SySch415/stm32-crawler/docs/images/2026-11-01_02-40-12.png

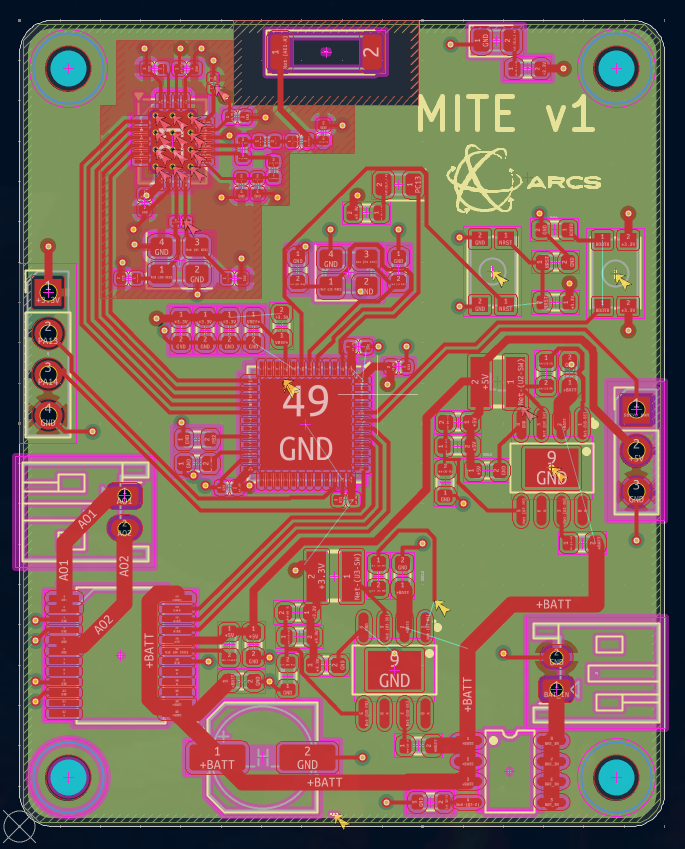
docs/images/2026-11-01_02-40-12.png
