SySch415/stm32-crawler/controller/startup.cpp

extern "C" {

#include <stdint.h>

extern uint32_t _estack;
extern uint32_t _sidata;
extern uint32_t _sdata;
extern uint32_t _edata;
extern uint32_t _sbss;
extern uint32_t _ebss;

extern int main(void);
void Reset_Handler();

void Default_Handler(void) {
  while (1)
    ;
}

void NMI_Handler(void) __attribute__((weak, alias("Default_Handler")));
void HardFault_Handler(void) __attribute__((weak, alias("Default_Handler")));
void MemManage_Handler(void) __attribute__((weak, alias("Default_Handler")));
void BusFault_Handler(void) __attribute__((weak, alias("Default_Handler")));
void UsageFault_Handler(void) __attribute__((weak, alias("Default_Handler")));
void SVC_Handler(void) __attribute__((weak, alias("Default_Handler")));
void DebugMon_Handler(void) __attribute__((weak, alias("Default_Handler")));
void PendSV_Handler(void) __attribute__((weak, alias("Default_Handler")));
void SysTick_Handler(void) __attribute__((weak, alias("Default_Handler")));
void TIM2_IRQHandler(void) __attribute__((weak, alias("Default_Handler")));

__attribute__((section(".isr_vector"))) uint32_t *vector_table[] = {
    (uint32_t *)&_estack,
    (uint32_t *)Reset_Handler,
    (uint32_t *)NMI_Handler,
    (uint32_t *)HardFault_Handler,
    (uint32_t *)MemManage_Handler,
    (uint32_t *)BusFault_Handler,
    (uint32_t *)UsageFault_Handler,
    0,
    0,
    0,
    0,
    (uint32_t *)SVC_Handler,
    (uint32_t *)DebugMon_Handler,
    0,
    (uint32_t *)PendSV_Handler,
    (uint32_t *)SysTick_Handler,

    //[44] = (uint32_t *)TIM2_IRQHandler,
};

void Reset_Handler(void) {
  uint32_t *src = &_sidata;
  uint32_t *dst = &_sdata;

  while (dst < &_edata) {
    *dst++ = *src++;
  }

  dst = &_sbss;

  while (dst < &_ebss) {
    *dst++ = 0;
  }

  main();
}
}
