SySch415/stm32-crawler/(commit log)

2026-05-20 update: added hardware dir with kicad schems
    [crawler_schematic.kicad_pcb, crawler_schematic.kicad_sch]
2026-05-21 update: added rx/tx methods to nrf driver
2026-05-22 update: finish nrf driver implement
2026-05-22 update: updated drivers, CMake, rx debugging
2026-05-23 update: fixed tx/rx flag clearing, updated hal lib, other
    [main.cpp, nrf24.cpp, nrf24.hpp]
2026-05-28 update: update kicad schem for h bridge power
    [crawler_schematic.kicad_sch]
2026-06-04 update: added ADC class to cmake build and controller functionality
2026-06-05 update: updated nrf constructor to better handle stale state, implemented rf throttle poc
2026-06-08 update: added vr_x joystick logic for steering, added deadband logic for idle positions
2026-06-09 update: added drivetrain motor logic method, conversion of adc val to pwm
2026-06-09 update: added controller schematic
    [controller_schematic.kicad_pcb, controller_schematic.kicad_sch]
2026-06-09 remove kicad .history from tracking
2026-06-10 update: added servo steering logic
2026-06-10 update: update crawler schematic for servo pwm to pb4
    [crawler_schematic.kicad_sch]
2026-06-19 update: update controller schematic for 2 axis to 3.3v instead of 5v
    [controller_schematic.kicad_sch]
2026-06-20 update: schematic cleanups
    [crawler_schematic.kicad_sch]
2026-06-23 update: updated schematics, reimplemented main firmware after nrf/spi troubleshooting
2026-09-02 fix: 5V/Gnd schema for servo and buck
    [crawler_schematic.kicad_sch]
2026-09-19 update: schematic cleanup for pcb_r1
    [crawler_schematic.kicad_sch, power.kicad_sch]
2026-09-21 update: schematic complete, start pcb design
    [crawler_schematic.kicad_pcb, crawler_schematic.kicad_sch, power.kicad_sch]
2026-09-22 update: pcb work
    [crawler_schematic.kicad_pcb, power.kicad_sch]
2026-09-23 update: pcb work, power layers
    [crawler_schematic.kicad_pcb]
2026-10-14 update: revamp crawler schematic
2026-10-30 fix: CSN going high too early caused 4 byte corruption, CRC blocked RX. Delay added to chip_deselect in nrf driver, not full solution
